arsenal007/PCM2900C_SI570_PCB/README.md

# PCM2900C Si570
KiCAD PCB Project of SDR processor board, based on PCM2900C and Si570
