arsenal007/PCM2900C_SI570_PCB/LCSDR.kicad_pcb

## KiCad design LCSDR.kicad_pcb (2020-07-03)

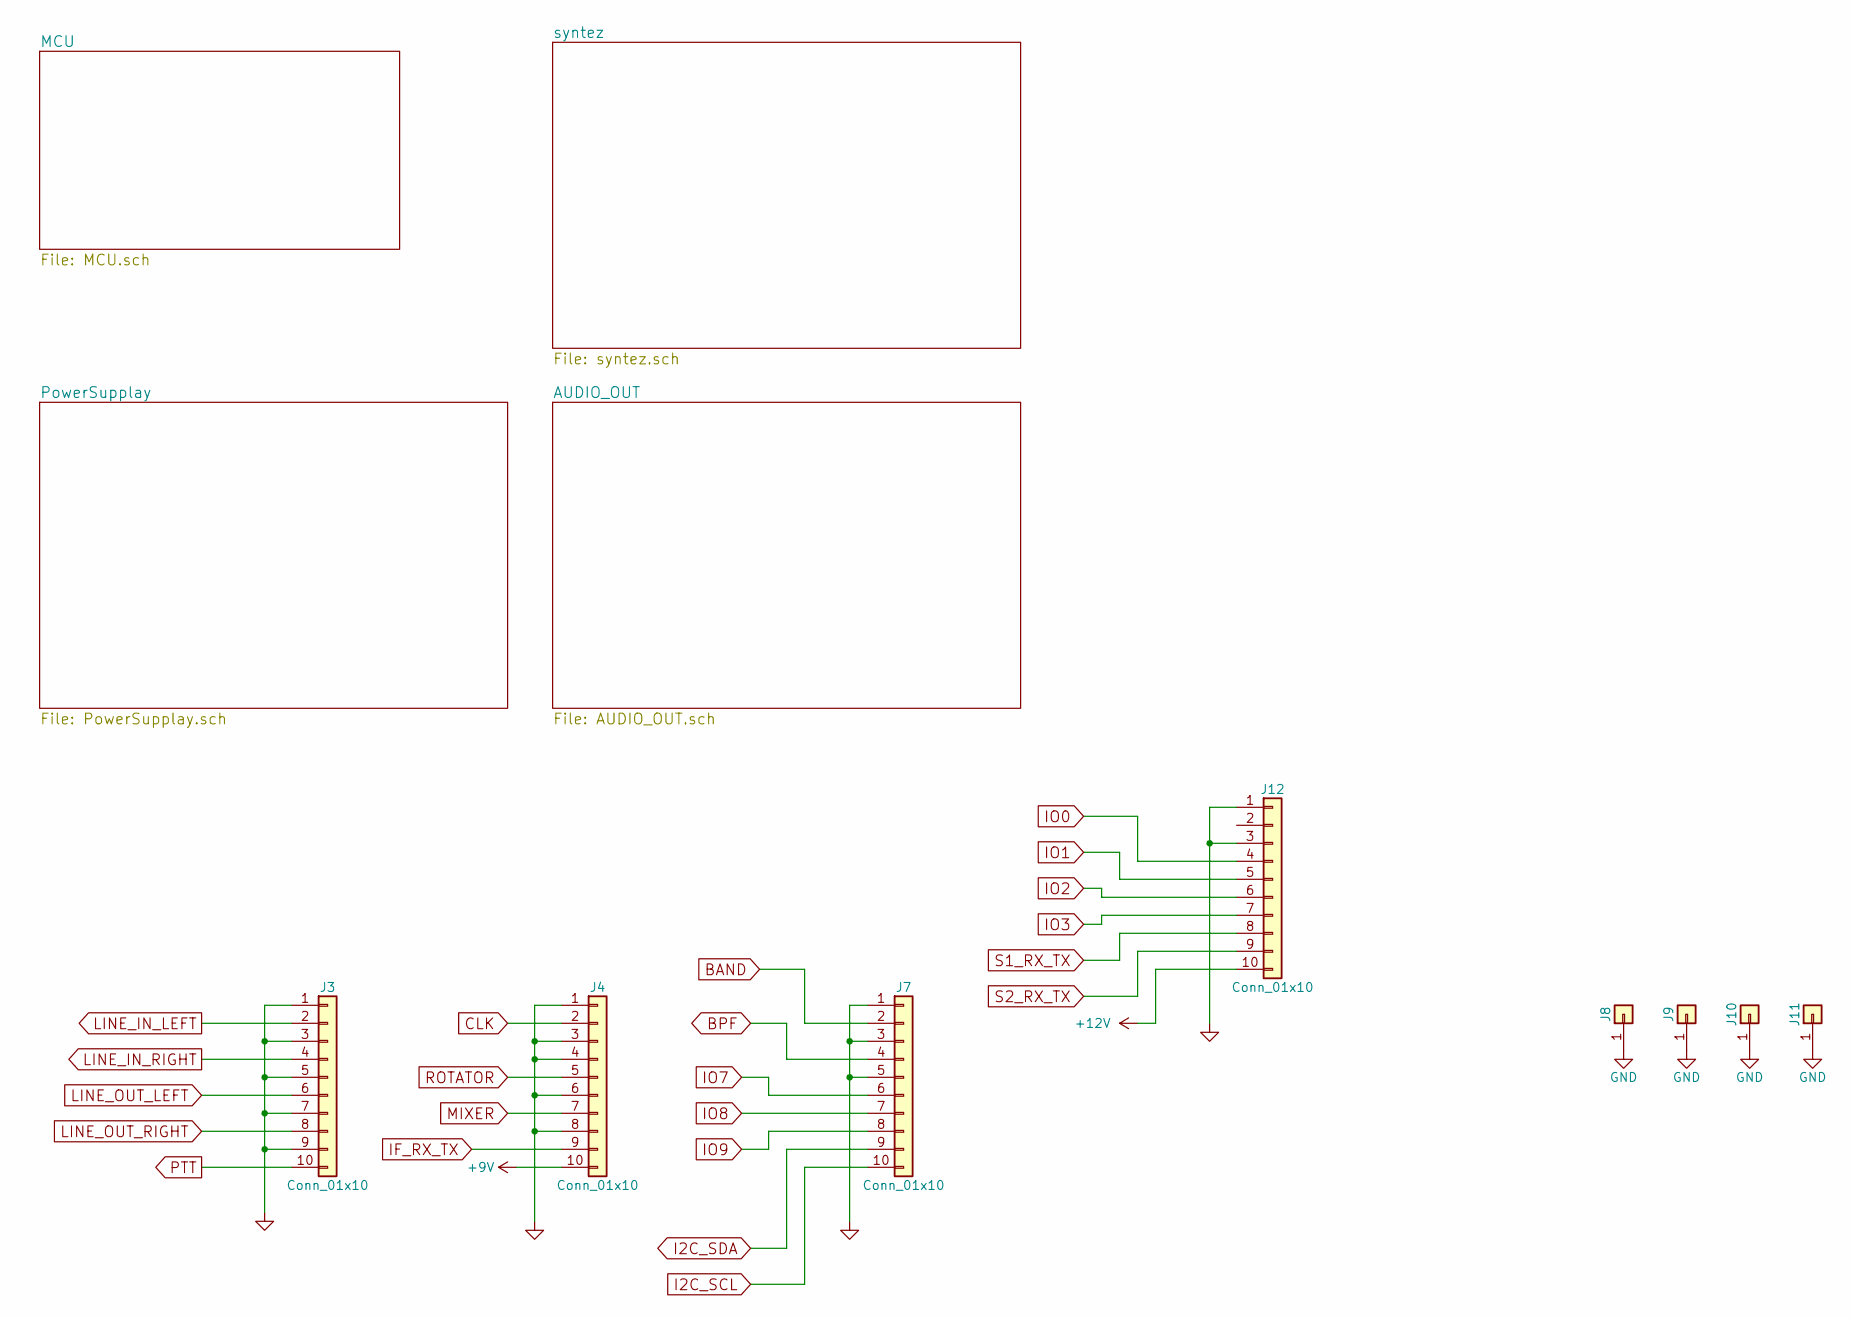
[picture p1: schematic LCSDR.sch, Hermes-Lite]

Parts:
J3, J4, J7, J12: Conn_01x10; Pin_Header_Straight_1x10_Pitch2.54mm
J8, J9, J10, J11: Conn_01x01; MountingHole_3.2mm_M3_DIN965_Pad

Connections:
+9V: J4.10; also elsewhere on the board
+12V: J12.10; also elsewhere on the board
BAND: J7.2; also elsewhere on the board
CLK: J4.2; also elsewhere on the board
GND: J3.1, J3.3, J3.5, J3.7, J3.9, J4.1, J4.3, J4.4, J4.6, J4.8, J7.1, J7.3, J7.5, J8.1, J9.1, J10.1, J11.1, J12.1, J12.3; also elsewhere on the board
I2C_SCL: J7.10; also elsewhere on the board
I2C_SDA: J7.9; also elsewhere on the board
IF_RX_TX: J4.9; also elsewhere on the board
IO0: J12.4; also elsewhere on the board
IO1: J12.5; also elsewhere on the board
IO2: J12.6; also elsewhere on the board
IO3: J12.7; also elsewhere on the board
IO7: J7.6; also elsewhere on the board
IO8: J7.7; also elsewhere on the board
IO9: J7.8; also elsewhere on the board
LINE_IN_LEFT: J3.2; also elsewhere on the board
LINE_IN_RIGHT: J3.4; also elsewhere on the board
LINE_OUT_LEFT: J3.6; also elsewhere on the board
LINE_OUT_RIGHT: J3.8; also elsewhere on the board
MIXER: J4.7; also elsewhere on the board
ROTATOR: J4.5; also elsewhere on the board
S1_RX_TX: J12.8; also elsewhere on the board
S2_RX_TX: J12.9; also elsewhere on the board

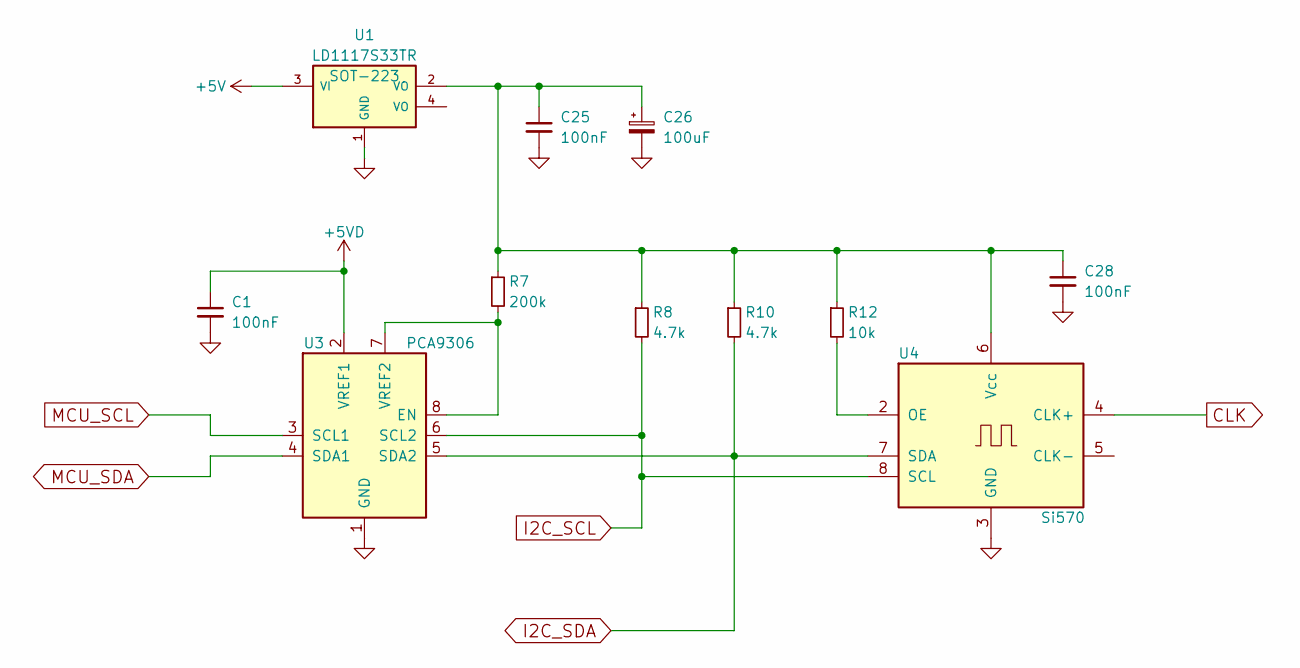
[picture p2: schematic syntez.sch]

Parts:
C1, C25, C28: 100nF; C_1206_0603
C26: 100uF; CP_Radial_D6.3mm_P2.50mm
R7: 200k; R_1206_0603
R8, R10: 4.7k; R_1206_0603
R12: 10k; R_1206_0603
U1: LD1117S33TR; SOT-223
U3: PCA9306; SSOP-8_2.95x2.8mm_Pitch0.65mm
U4: Si570; Oscillator_SMD_SI570_SI571_Standard

Connections:
+5V: U1.3 (VI); also elsewhere on the board
+5VD: C1.1, U3.2 (VREF1); also elsewhere on the board
CLK: U4.4 (CLK+); also elsewhere on the board
GND: C1.2, C25.2, C26.2, C28.2, U1.1 (GND), U3.1 (GND), U4.3 (GND); also elsewhere on the board
I2C_SCL: R8.2, U3.6 (SCL2), U4.8 (SCL); also elsewhere on the board
I2C_SDA: R10.2, U3.5 (SDA2), U4.7 (SDA); also elsewhere on the board
MCU_SCL: U3.3 (SCL1); also elsewhere on the board
MCU_SDA: U3.4 (SDA1); also elsewhere on the board
unnamed: C25.1, C26.1, C28.1, R7.1, R8.1, R10.1, R12.1, U1.2 (VO), U4.6 (Vcc)
unnamed: R7.2, U3.7 (VREF2), U3.8 (EN)
unnamed: R12.2, U4.2 (OE)

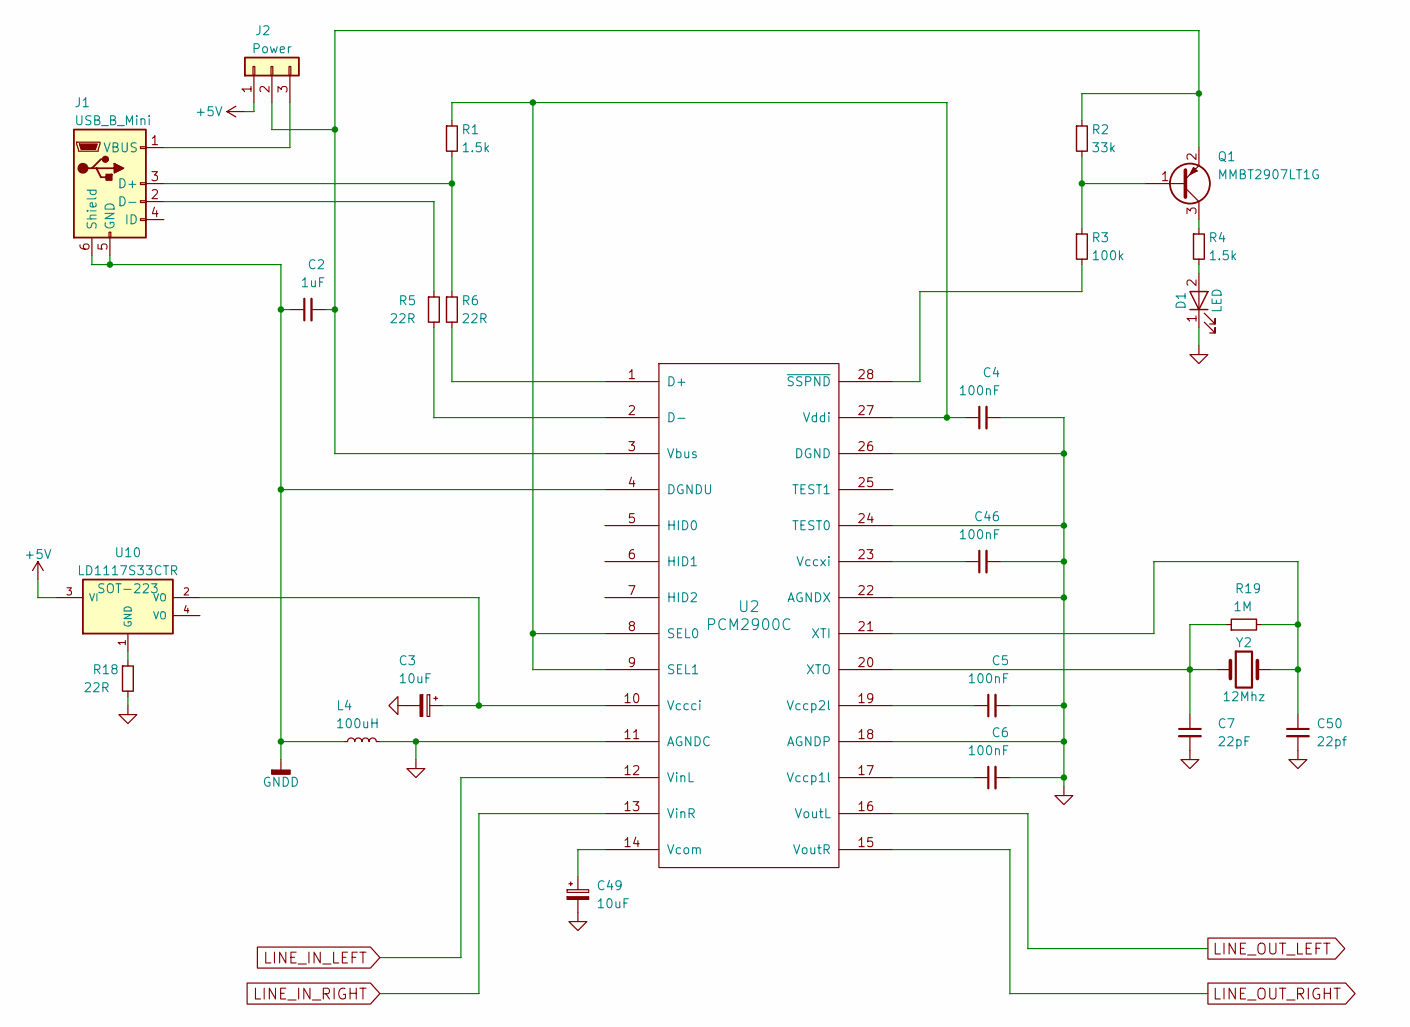
[picture p3: schematic AUDIO_OUT.sch]

Parts:
C2: 1uF; C_1206_0603
C3, C49: 10uF; CP_Radial_D5.0mm_P2.00mm
C4, C5, C6, C46: 100nF; C_1206_0603
C7: 22pF; C_1206_0603
C50: 22pf; C_1206_0603
D1: LED; LED_0603_HandSoldering
J1: USB_B_Mini; USB_Mini-B
J2: Power; Pin_Header_Straight_1x03_Pitch2.54mm
L4: 100uH; Choke_Horizontal_RM10mm
Q1: MMBT2907LT1G; SOT-23
R1, R4: 1.5k; R_1206_0603
R2: 33k; R_1206_0603
R3: 100k; R_1206_0603
R5, R6, R18: 22R; R_1206_0603
R19: 1M; R_1206_0603
U2: PCM2900C; SSOP-28_5.3x10.2mm_Pitch0.65mm
U10: LD1117S33CTR; SOT-223
Y2: 12Mhz; Crystal_HC49-U_Vertical

Connections:
+5V: J2.1, U10.3 (VI); also elsewhere on the board
GND: C3.2, C4.2, C5.2, C6.2, C7.2, C46.2, C49.2, C50.2, D1.1 (K), L4.2, R18.2, U2.11 (AGNDC), U2.18 (AGNDP), U2.22 (AGNDX), U2.24 (TEST0), U2.26 (DGND); also elsewhere on the board
GNDD: C2.1, J1.5 (GND), J1.6 (Shield), L4.1, U2.4 (DGNDU)
LINE_IN_LEFT: U2.12 (VinL); also elsewhere on the board
LINE_IN_RIGHT: U2.13 (VinR); also elsewhere on the board
LINE_OUT_LEFT: U2.16 (VoutL); also elsewhere on the board
LINE_OUT_RIGHT: U2.15 (VoutR); also elsewhere on the board
unnamed: C2.2, J2.2, Q1.2 (E), R2.1, U2.3 (Vbus)
unnamed: C3.1, U2.10 (Vccci), U10.2 (VO)
unnamed: C4.1, R1.1, U2.8 (SEL0), U2.9 (SEL1), U2.27 (Vddi)
unnamed: C5.1, U2.19 (Vccp2l)
unnamed: C6.1, U2.17 (Vccp1l)
unnamed: C7.1, R19.1, U2.20 (XTO), Y2.1
unnamed: C46.1, U2.23 (Vccxi)
unnamed: C49.1, U2.14 (Vcom)
unnamed: C50.1, R19.2, U2.21 (XTI), Y2.2
unnamed: D1.2 (A), R4.2
unnamed: J1.1 (VBUS), J2.3
unnamed: J1.2 (D-), R5.1
unnamed: J1.3 (D+), R1.2, R6.1
unnamed: Q1.1 (B), R2.2, R3.1
unnamed: Q1.3 (C), R4.1
unnamed: R3.2, U2.28 (~SSPND)
unnamed: R5.2, U2.2 (D-)
unnamed: R6.2, U2.1 (D+)
unnamed: R18.1, U10.1 (GND)

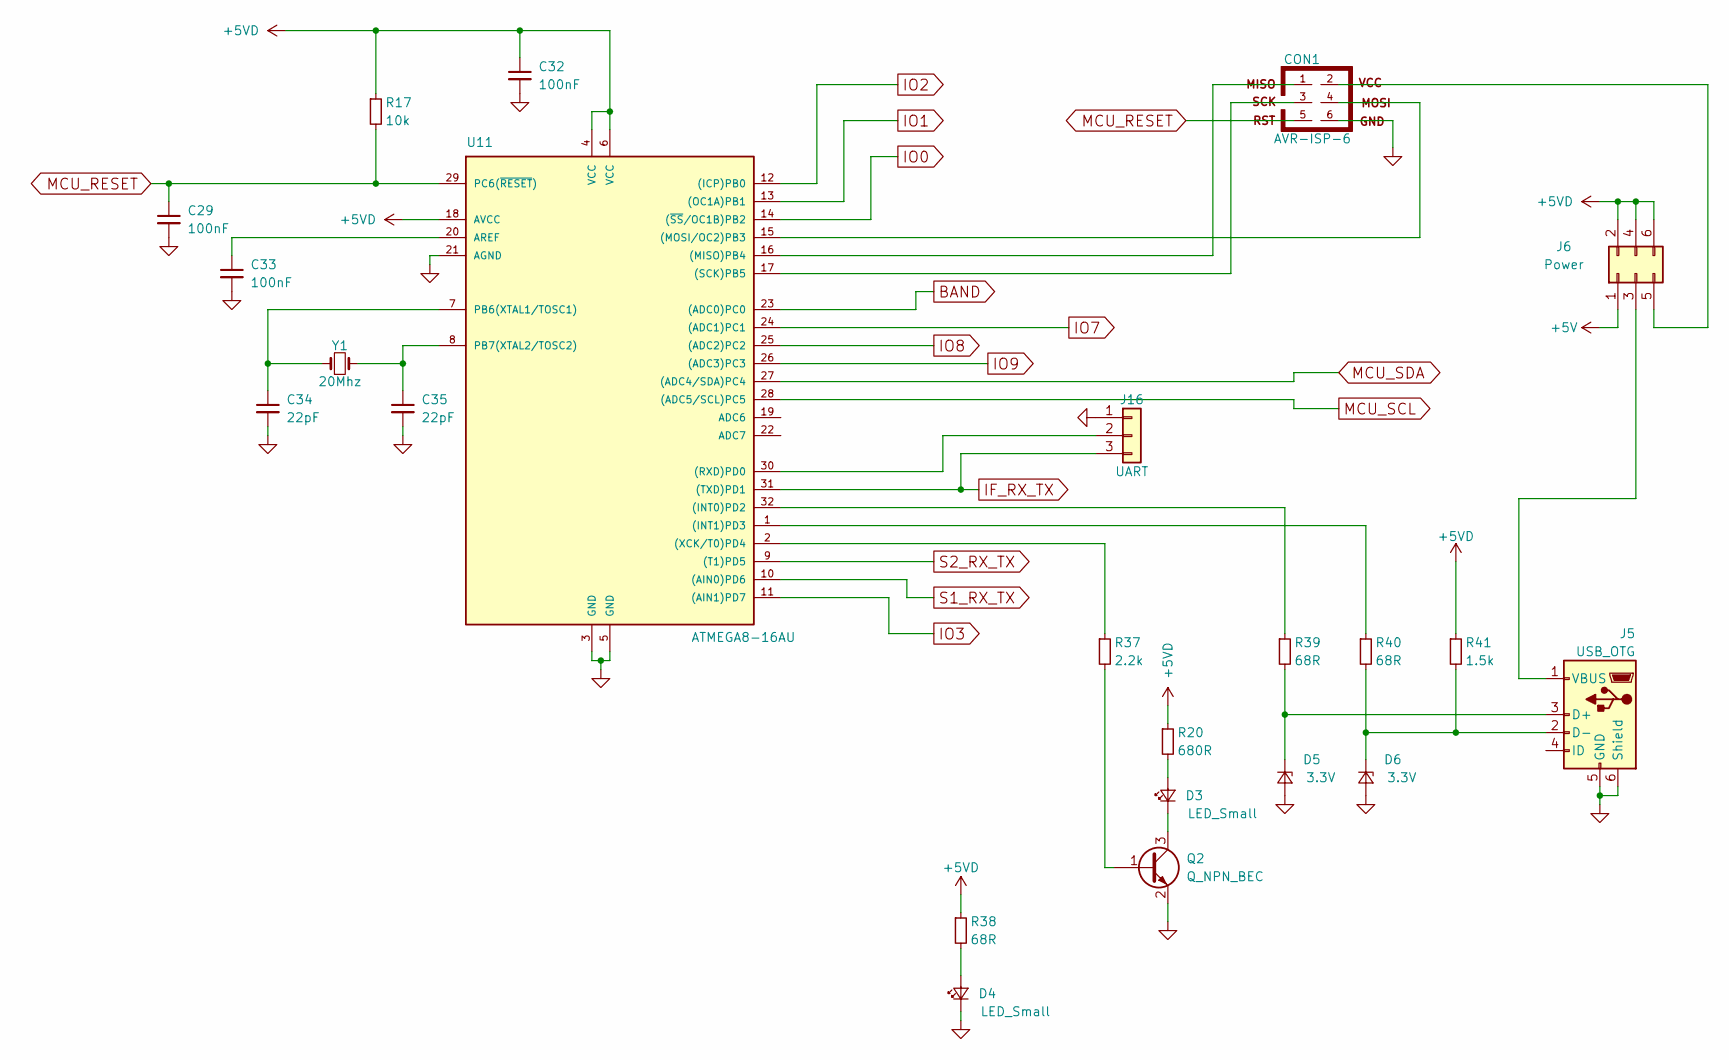
[picture p4: schematic MCU.sch]

Parts:
C29, C32, C33: 100nF; C_1206_0603
C34, C35: 22pF; C_1206_0603
CON1: AVR-ISP-6; Pin_Header_Straight_2x03_Pitch2.54mm
D3, D4: LED_Small; LED_0603_HandSoldering
D5, D6: 3.3V; D_MiniMELF
J5: USB_OTG; USB_Mini-B
J6: Power; Pin_Header_Straight_2x03_Pitch2.54mm
J16: UART; Pin_Header_Straight_1x03_Pitch2.54mm
Q2: Q_NPN_BEC; SOT-23
R17: 10k; R_1206_0603
R20: 680R; R_1206_0603
R37: 2.2k; R_1206_0603
R38, R39, R40: 68R; R_1206_0603
R41: 1.5k; R_1206_0603
U11: ATMEGA8-16AU; TQFP-32_7x7mm_Pitch0.8mm
Y1: 20Mhz; Crystal_HC49-U_Vertical

Connections:
+5V: J6.1; also elsewhere on the board
+5VD: C32.1, J6.2, J6.4, J6.6, R17.1, R20.1, R38.1, R41.1, U11.4 (VCC), U11.6 (VCC), U11.18 (AVCC); also elsewhere on the board
BAND: U11.23 ((ADC0)PC0); also elsewhere on the board
GND: C29.2, C32.2, C33.2, C34.2, C35.2, CON1.6, D4.1 (K), D5.2 (A), D6.2 (A), J5.5 (GND), J5.6 (Shield), J16.1, Q2.2 (E), U11.3 (GND), U11.5 (GND), U11.21 (AGND); also elsewhere on the board
IF_RX_TX: J16.3, U11.31 ((TXD)PD1); also elsewhere on the board
IO0: U11.14 ((~SS~/OC1B)PB2); also elsewhere on the board
IO1: U11.13 ((OC1A)PB1); also elsewhere on the board
IO2: U11.12 ((ICP)PB0); also elsewhere on the board
IO3: U11.11 ((AIN1)PD7); also elsewhere on the board
IO7: U11.24 ((ADC1)PC1); also elsewhere on the board
IO8: U11.25 ((ADC2)PC2); also elsewhere on the board
IO9: U11.26 ((ADC3)PC3); also elsewhere on the board
MCU_RESET: C29.1, CON1.5, R17.2, U11.29 (PC6(~RESET~))
MCU_SCL: U11.28 ((ADC5/SCL)PC5); also elsewhere on the board
MCU_SDA: U11.27 ((ADC4/SDA)PC4); also elsewhere on the board
unnamed: C33.1, U11.20 (AREF)
unnamed: C34.1, U11.7 (PB6(XTAL1/TOSC1)), Y1.1
unnamed: C35.1, U11.8 (PB7(XTAL2/TOSC2)), Y1.2
unnamed: CON1.1, U11.16 ((MISO)PB4)
unnamed: CON1.2, J6.5
unnamed: CON1.3, U11.17 ((SCK)PB5)
unnamed: CON1.4, U11.15 ((MOSI/OC2)PB3)
unnamed: D3.1 (K), Q2.3 (C)
unnamed: D3.2 (A), R20.2
unnamed: D4.2 (A), R38.2
unnamed: D5.1 (K), J5.3 (D+), R39.2
unnamed: D6.1 (K), J5.2 (D-), R40.2, R41.2
unnamed: J5.1 (VBUS), J6.3
unnamed: J16.2, U11.30 ((RXD)PD0)
unnamed: Q2.1 (B), R37.2
unnamed: R37.1, U11.2 ((XCK/T0)PD4)
unnamed: R39.1, U11.32 ((INT0)PD2)
unnamed: R40.1, U11.1 ((INT1)PD3)
S1_RX_TX: U11.10 ((AIN0)PD6); also elsewhere on the board
S2_RX_TX: U11.9 ((T1)PD5); also elsewhere on the board

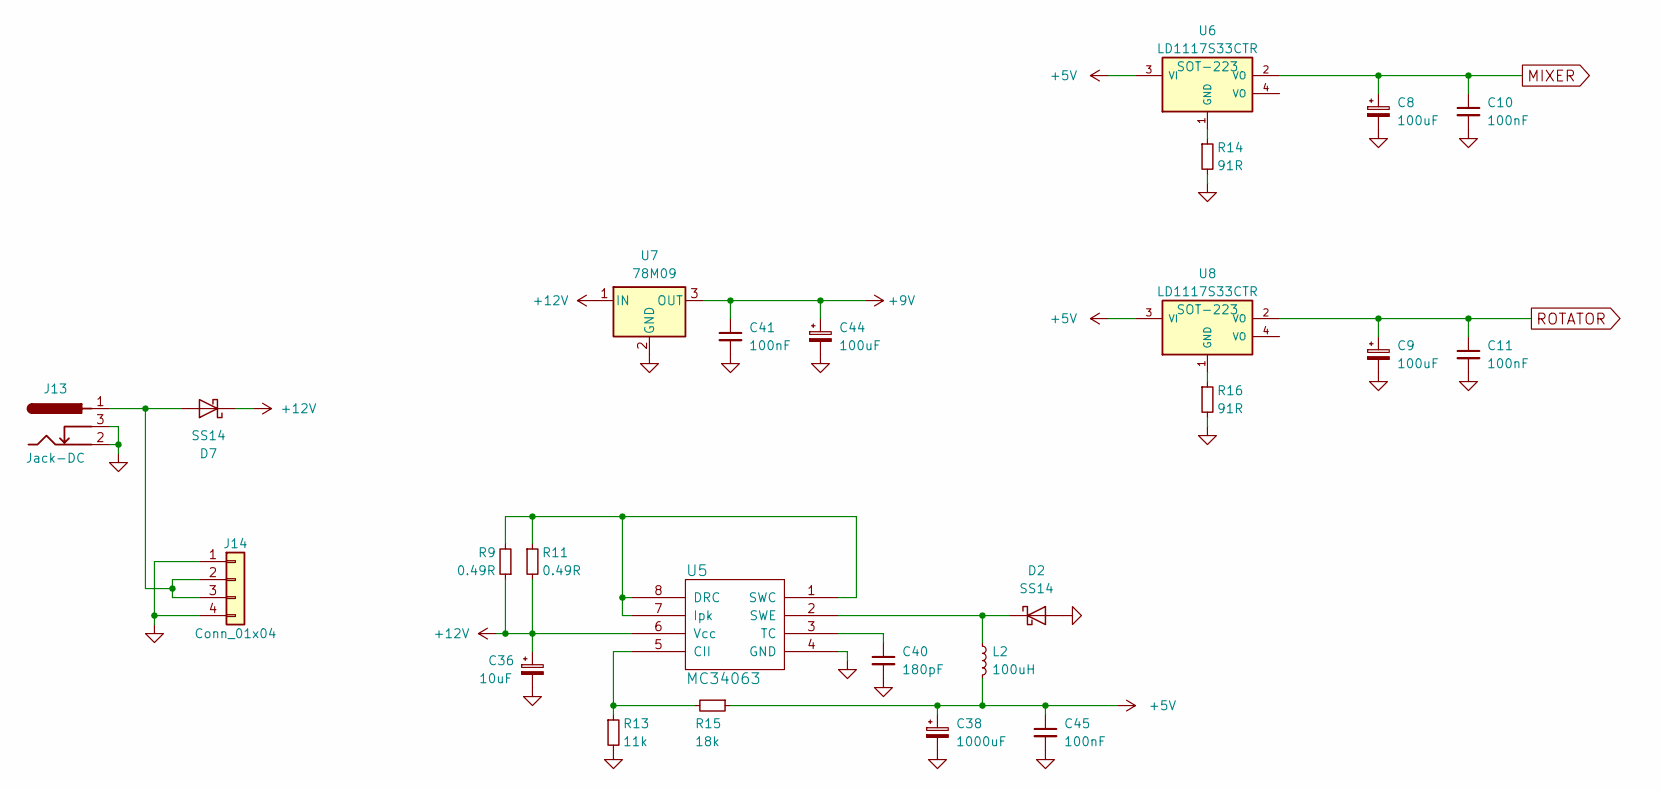
[picture p5: schematic PowerSupplay.sch]

Parts:
C8, C9, C44: 100uF; CP_Radial_D6.3mm_P2.50mm
C10, C11, C41, C45: 100nF; C_1206_0603
C36: 10uF; CP_Radial_D6.3mm_P2.50mm
C38: 1000uF; CP_Radial_D10.0mm_P5.00mm
C40: 180pF; C_1206_0603
D2: SS14; D_SMA_Handsoldering
D7: SS14; D_DO-41_SOD81_P10.16mm_Horizontal
J13: Jack-DC; BARREL_JACK
J14: Conn_01x04; Pin_Header_Straight_1x04_Pitch2.54mm
L2: 100uH; Choke_Toroid_5x10mm_Vertical
R9, R11: 0.49R; R_Axial_DIN0207_L6.3mm_D2.5mm_P10.16mm_Horizontal
R13: 11k; R_1206_0603
R14, R16: 91R; R_1206_0603
R15: 18k; R_1206_0603
U5: MC34063; SOIC-8_3.9x4.9mm_Pitch1.27mm
U6, U8: LD1117S33CTR; SOT-223
U7: 78M09; TO-252-2_Rectifier

Connections:
+5V: C38.1, C45.1, L2.2, R15.1, U6.3 (VI), U8.3 (VI); also elsewhere on the board
+9V: C41.1, C44.1, U7.3 (OUT); also elsewhere on the board
+12V: C36.1, D7.1 (K), R9.1, R11.2, U5.6 (Vcc), U7.1 (IN); also elsewhere on the board
GND: C8.2, C9.2, C10.2, C11.2, C36.2, C38.2, C40.2, C41.2, C44.2, C45.2, D2.2 (A), J13.2, J13.3, J14.1, J14.4, R13.2, R14.2, R16.2, U5.4 (GND), U7.2 (GND); also elsewhere on the board
MIXER: C8.1, C10.1, U6.2 (VO); also elsewhere on the board
unnamed: C40.1, U5.3 (TC)
unnamed: D2.1 (K), L2.1, U5.2 (SWE)
unnamed: D7.2 (A), J13.1, J14.2, J14.3
unnamed: R9.2, R11.1, U5.1 (SWC), U5.7 (Ipk), U5.8 (DRC)
unnamed: R13.1, R15.2, U5.5 (CII)
unnamed: R14.1, U6.1 (GND)
unnamed: R16.1, U8.1 (GND)
ROTATOR: C9.1, C11.1, U8.2 (VO); also elsewhere on the board

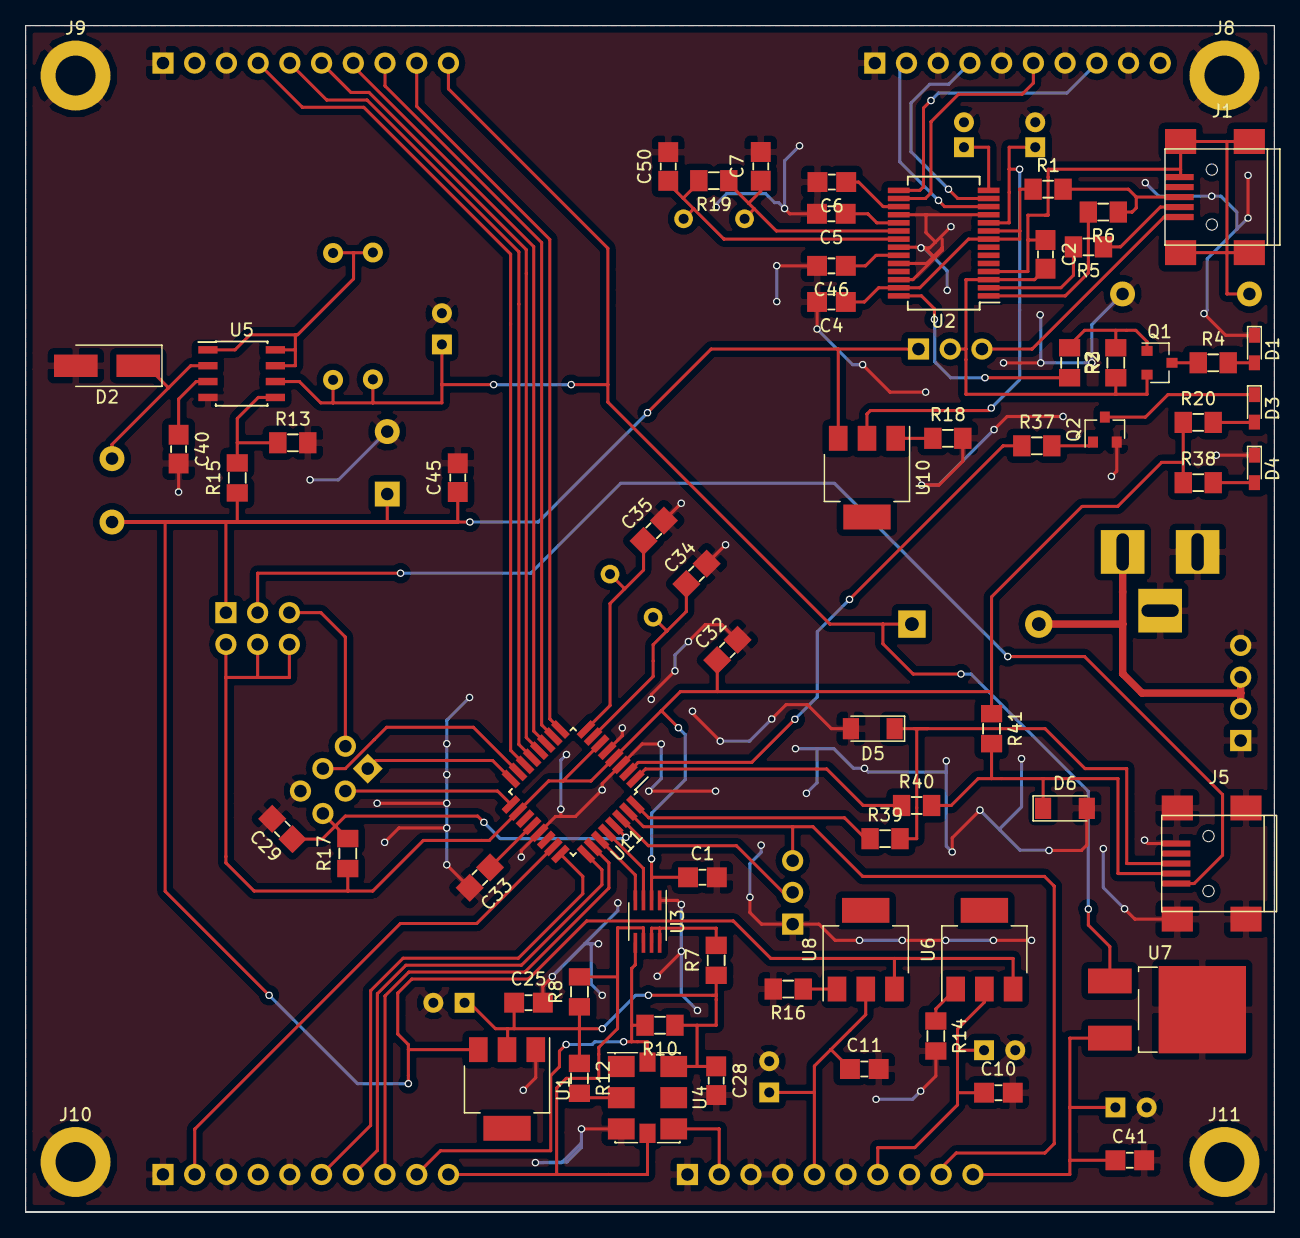
[picture p6: board LCSDR.kicad_pcb from above]

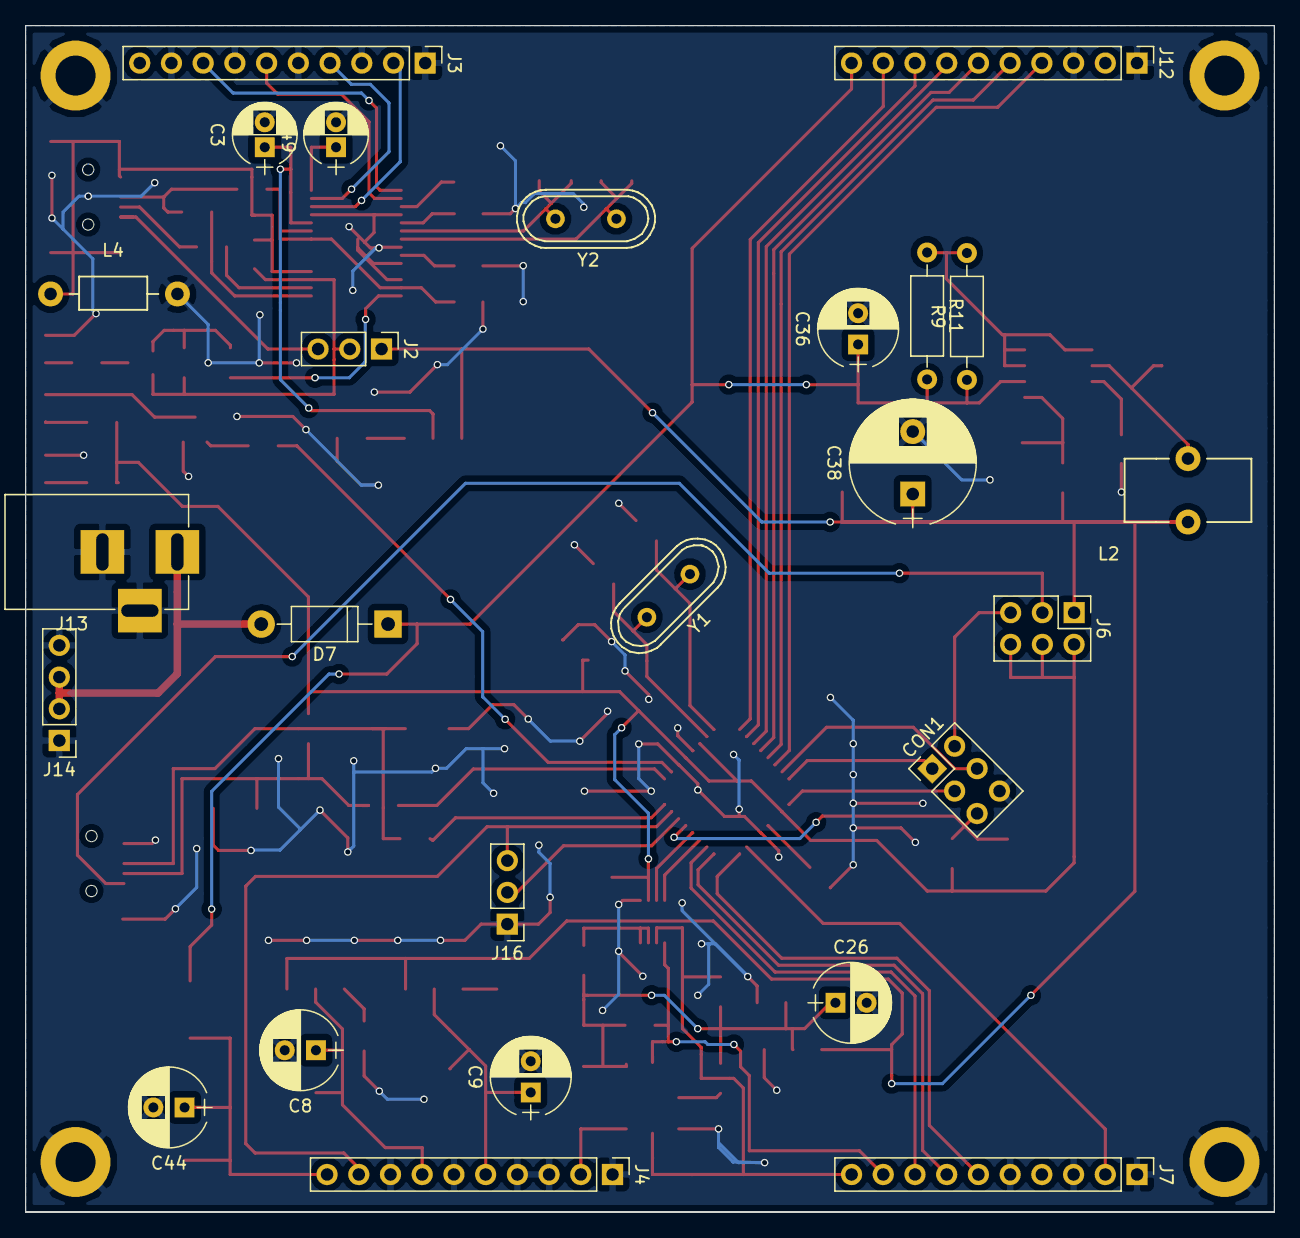
[picture p7: board LCSDR.kicad_pcb from below]

Board: 2 copper layers, 100.0 x 95.0 mm, 92 parts (25 on the bottom side), 76 nets.
